ku4qo/SS-40-Digital-Transceiver/docs/ss-40-interconnect.pdf

## LCD 4x20

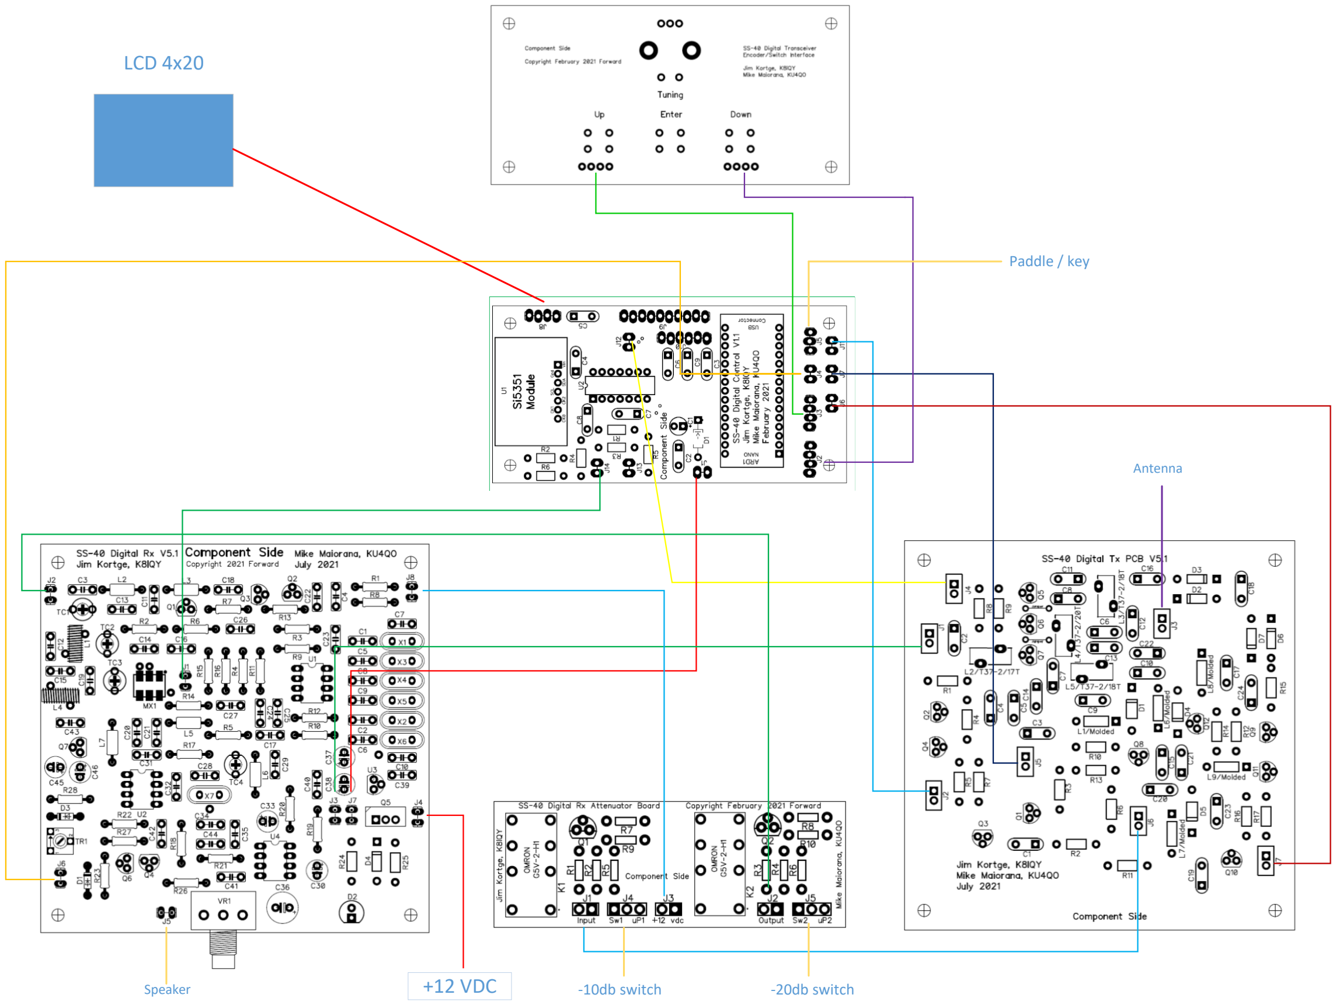
[picture p3: page 1]

## +12 VDC

Antenna

Speaker | -10db switch | -20db switch

Paddle / key
