ku4qo/SS-40-Digital-Transceiver/images/SS-40 Digital Transceiver - Controller-PowerSupplyMonitor-640 pix.jpg

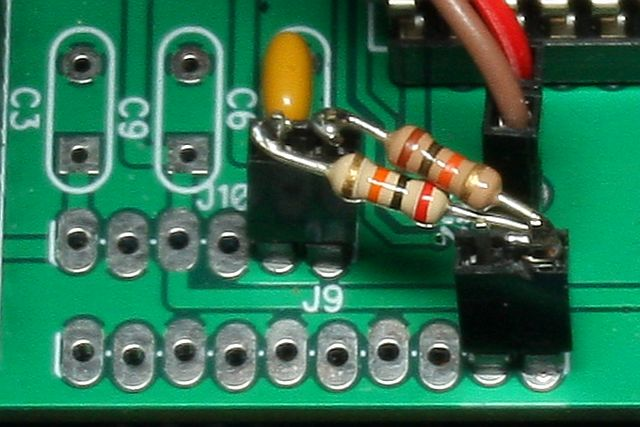
images/SS-40 Digital Transceiver - Controller-PowerSupplyMonitor-640 pix.jpg
