ku4qo/SS-40-Digital-Transceiver/images/SS-40 Digital Transceiver - Front2-1024 pix.jpg

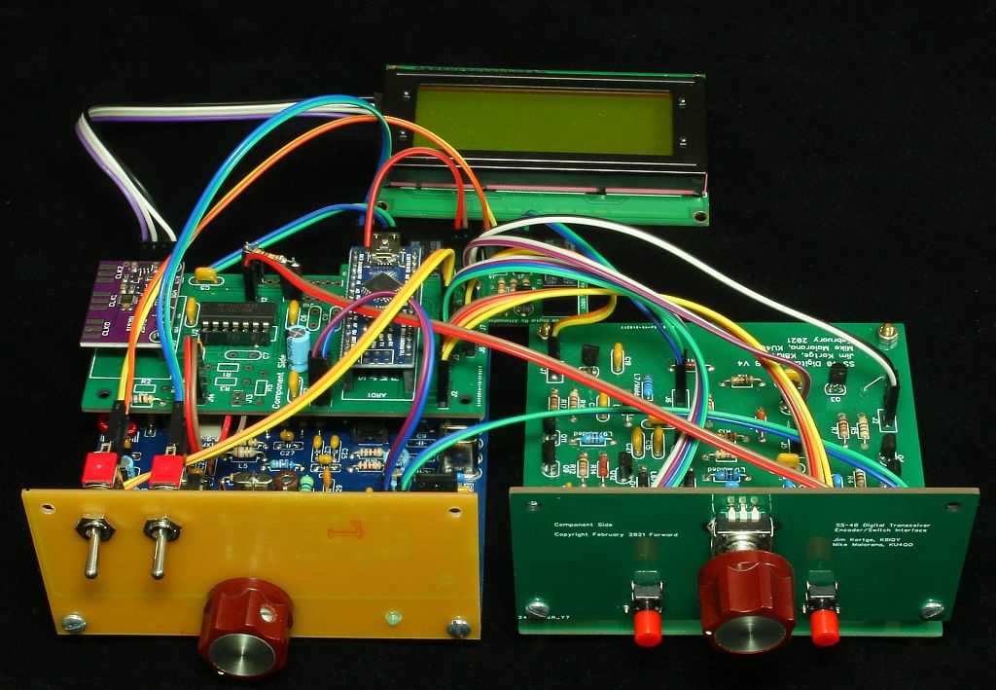
images/SS-40 Digital Transceiver - Front2-1024 pix.jpg
