ku4qo/SS-40-Digital-Transceiver/schematic/DipTrace Schematic - FrontEndAttenuatorV1.1.pdf

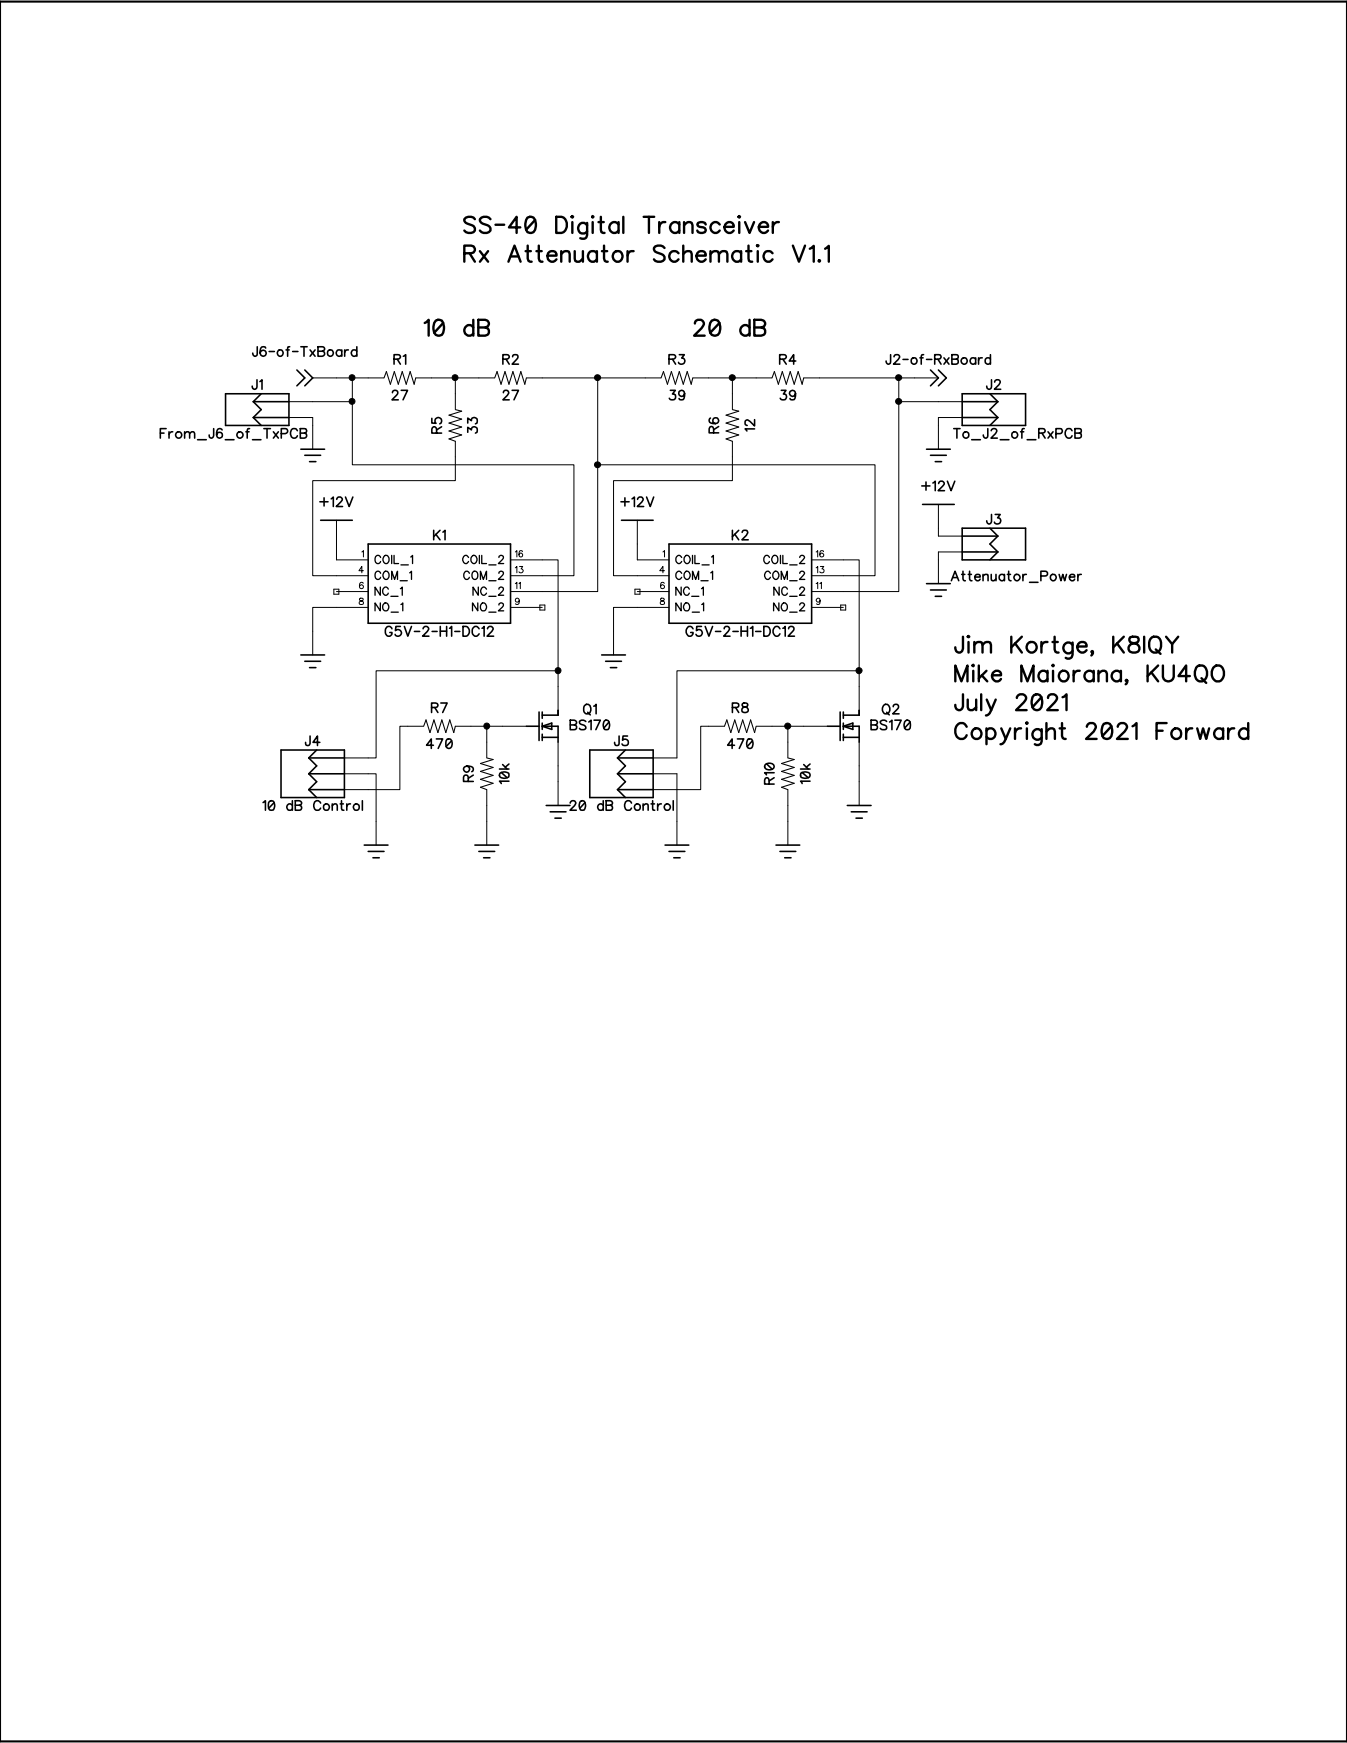
[picture p13: page 1]
