ku4qo/SS-40-Digital-Transceiver/schematic/DipTrace Schematic - SS-40Digital-Tx V5.1.pdf

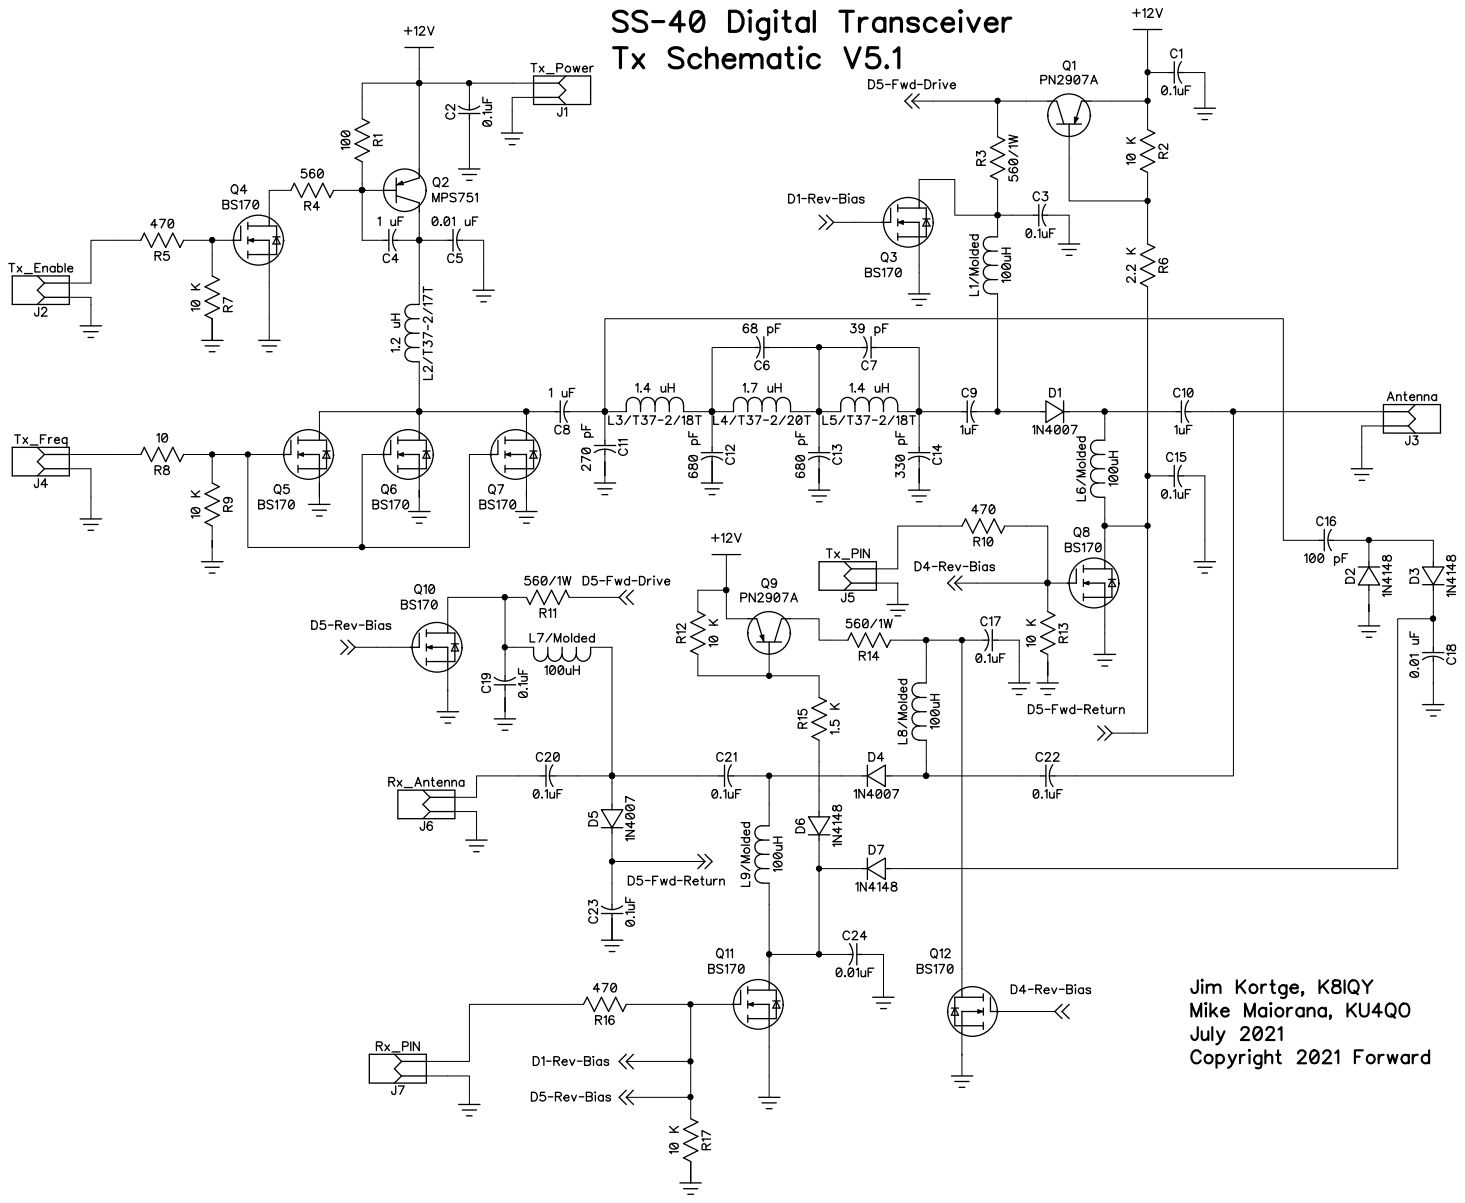
[picture p14: page 1]
