ku4qo/SS-40-Digital-Transceiver/schematic/DipTrace Schematic - SS-40DigitalControlV1.1.pdf

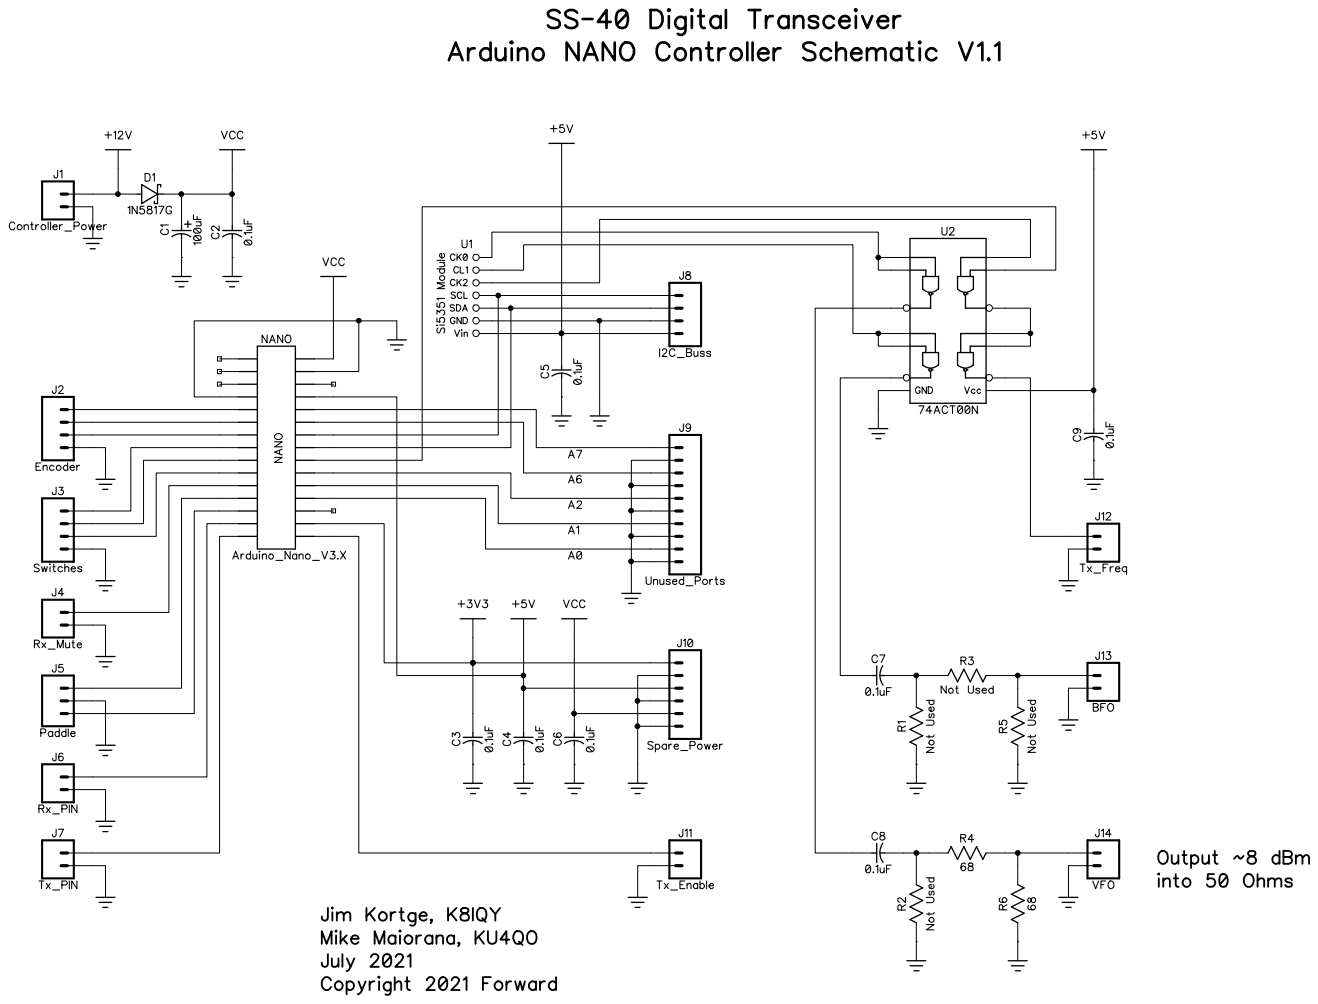
[picture p15: page 1]
