ku4qo/SS-40-Digital-Transceiver/schematic/DipTrace Schematic - SS-40RxDigitalV5.1.pdf

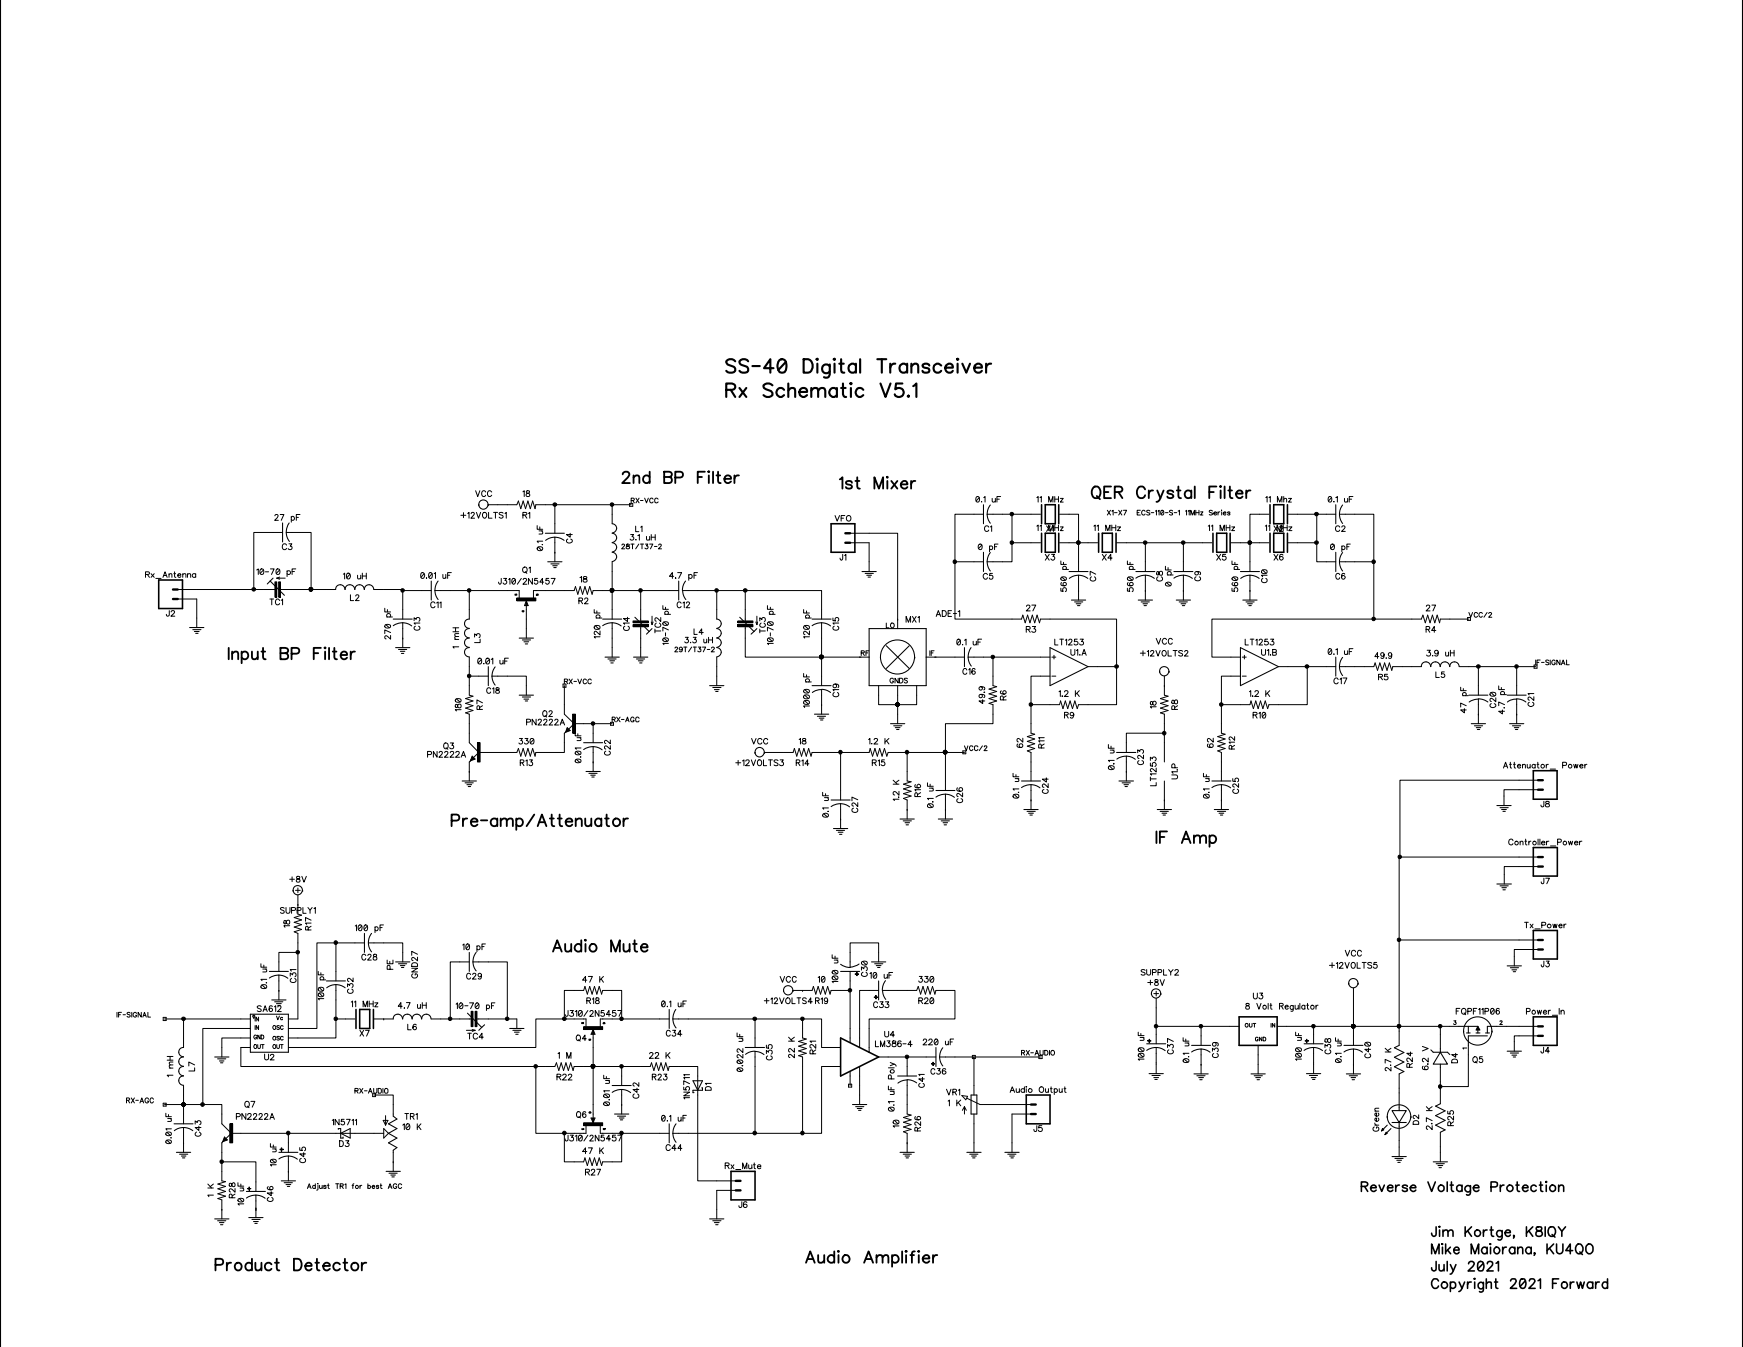
[picture p16: page 1]
