ku4qo/SS-40-Digital-Transceiver/pcb/DipTrace PCB - AttenuatorSwitchMountingV2.pdf

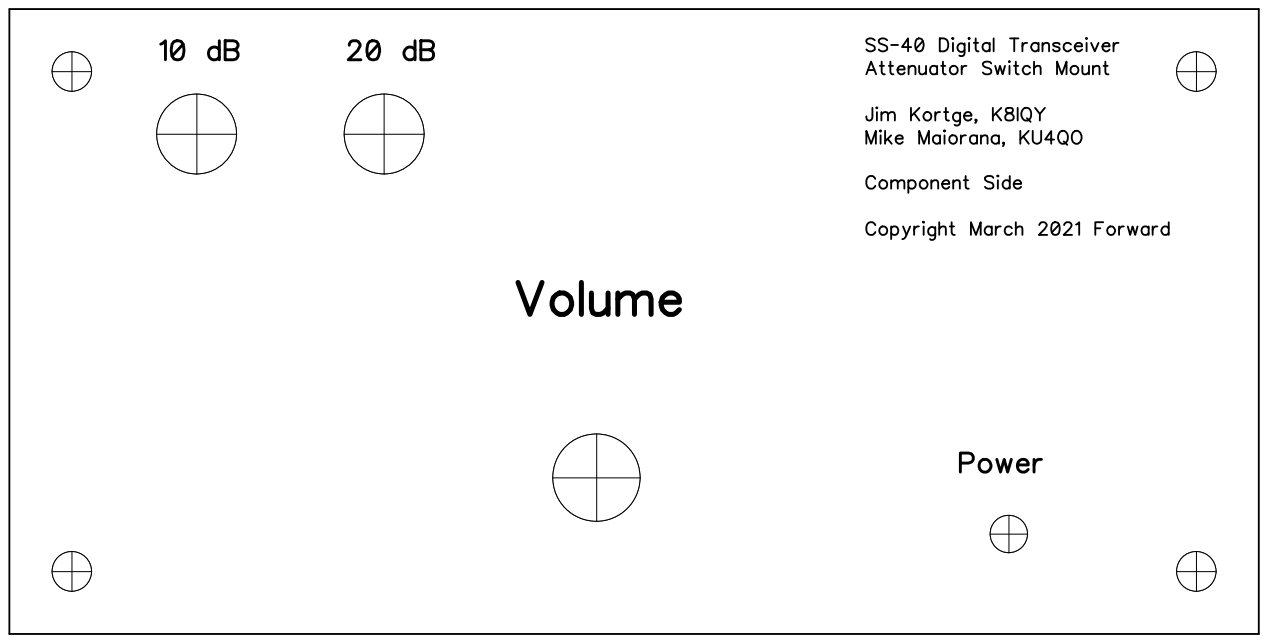
[picture p17: page 1]
