ku4qo/SS-40-Digital-Transceiver/pcb/DipTrace PCB - Encoder-Switch-MountingV2.pdf

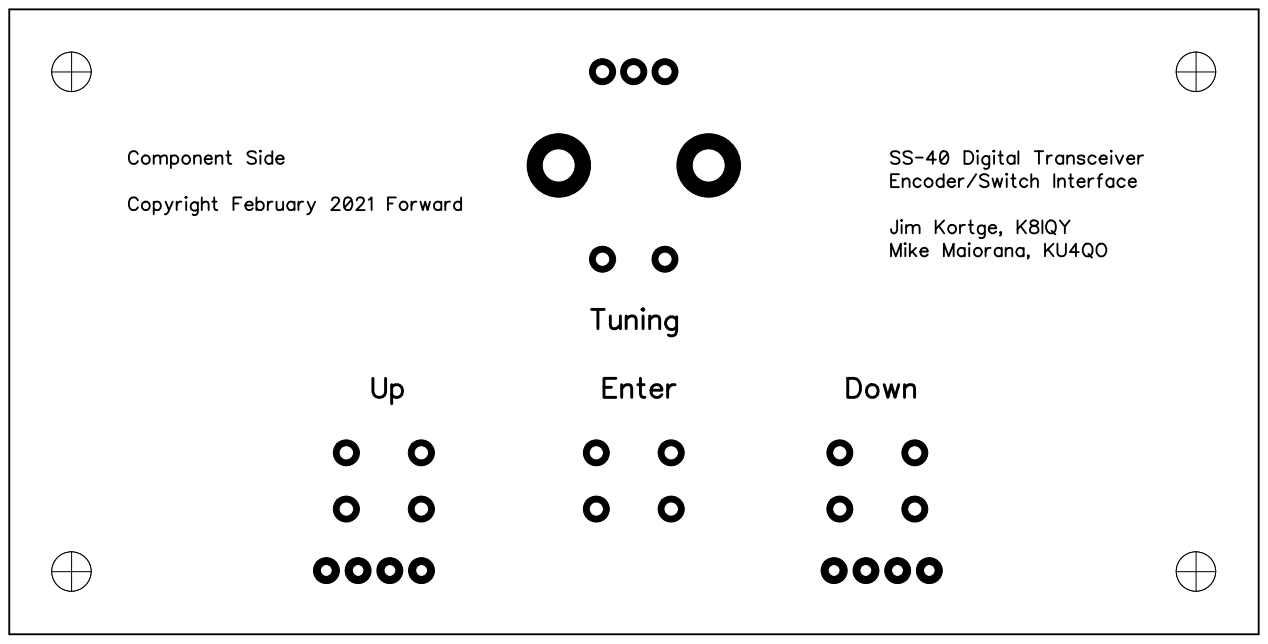
[picture p18: page 1]
