ku4qo/SS-40-Digital-Transceiver/pcb/DipTrace PCB - FrontEndAttenuatorV1.1.pdf

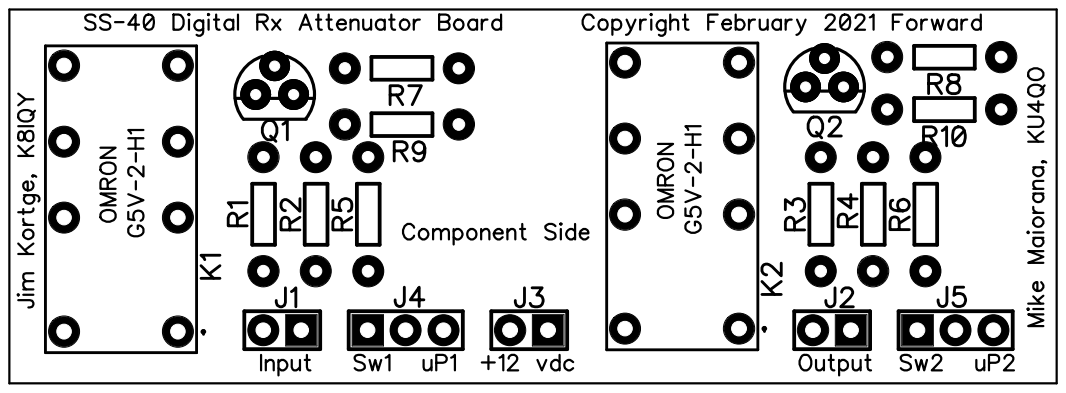
[picture p19: page 1]
