ku4qo/SS-40-Digital-Transceiver/pcb/DipTrace PCB - SS-40DigitalControlV1.1.pdf

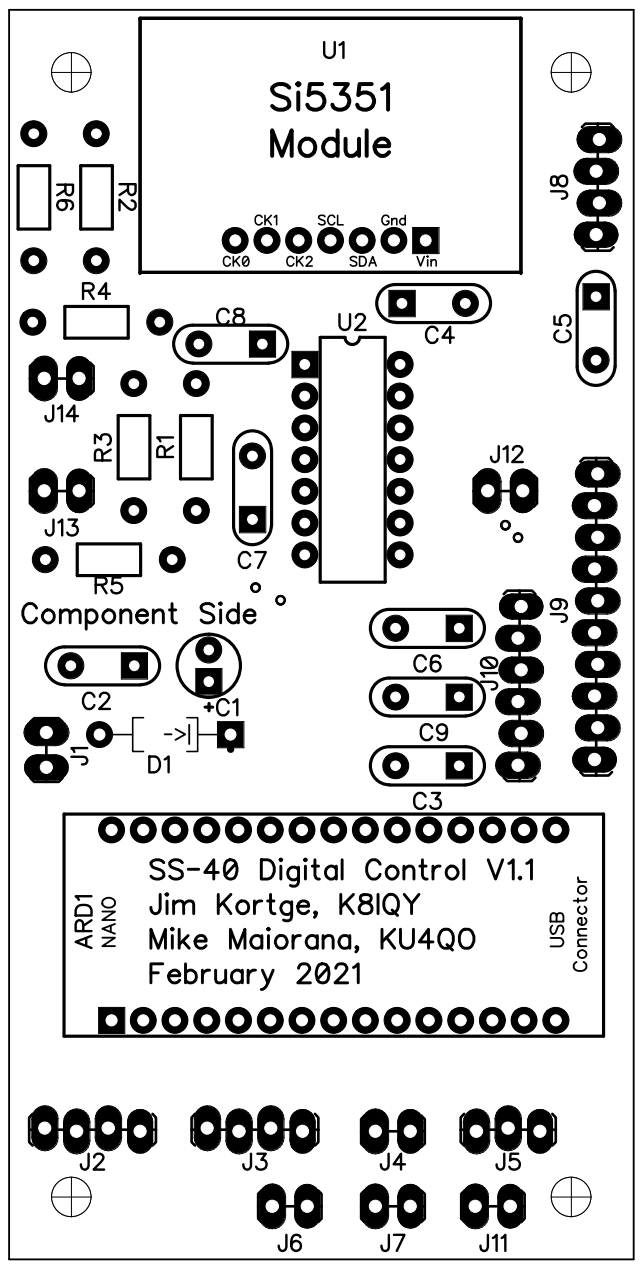
[picture p20: page 1]
