ku4qo/SS-40-Digital-Transceiver/pcb/DipTrace PCB - SS-40DigitalTxV5.1.pdf

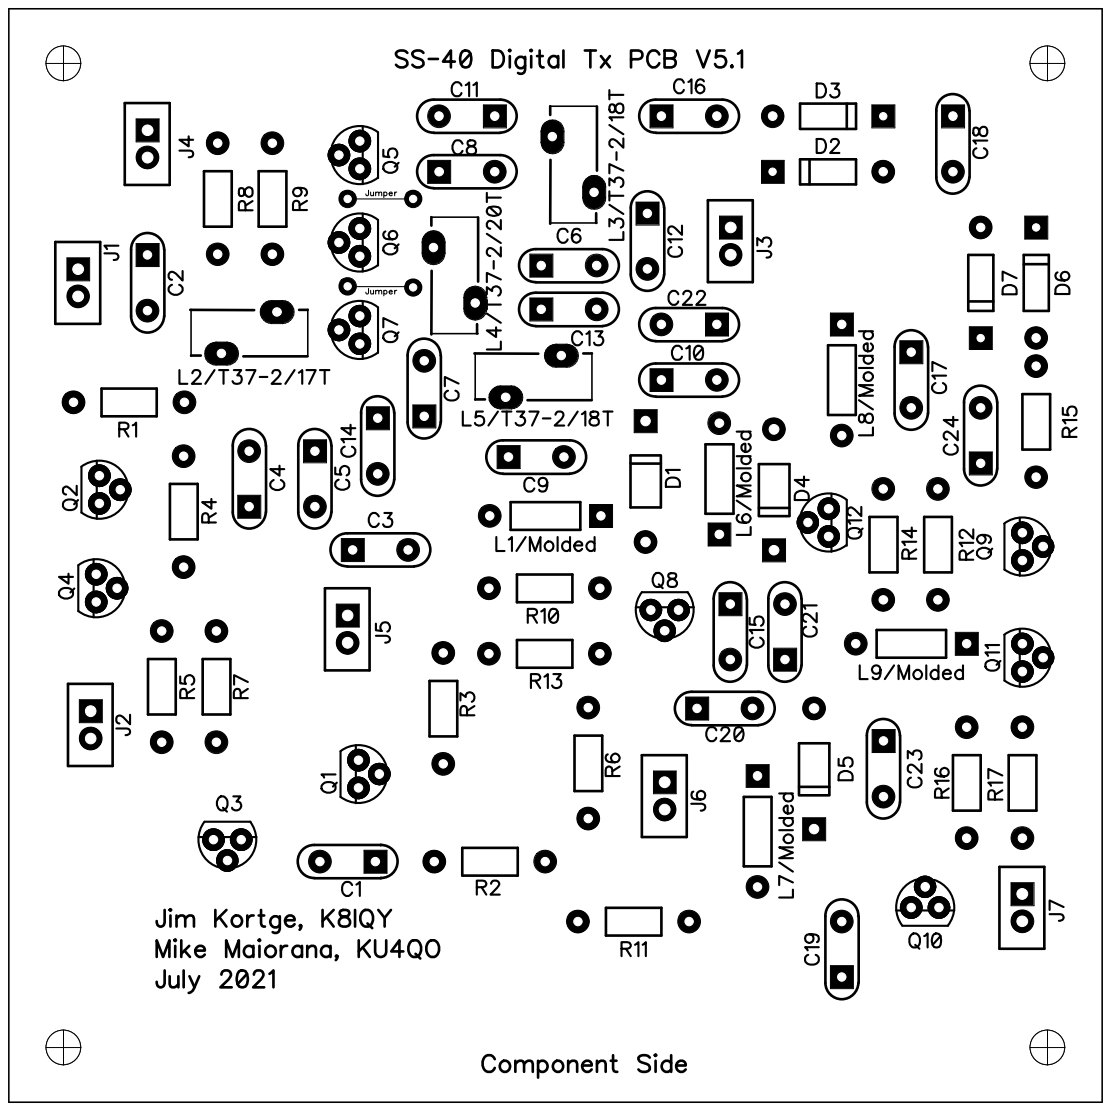
[picture p21: page 1]
