ku4qo/SS-40-Digital-Transceiver/pcb/DipTrace PCB - SS-40RxDigitalV5.1.pdf

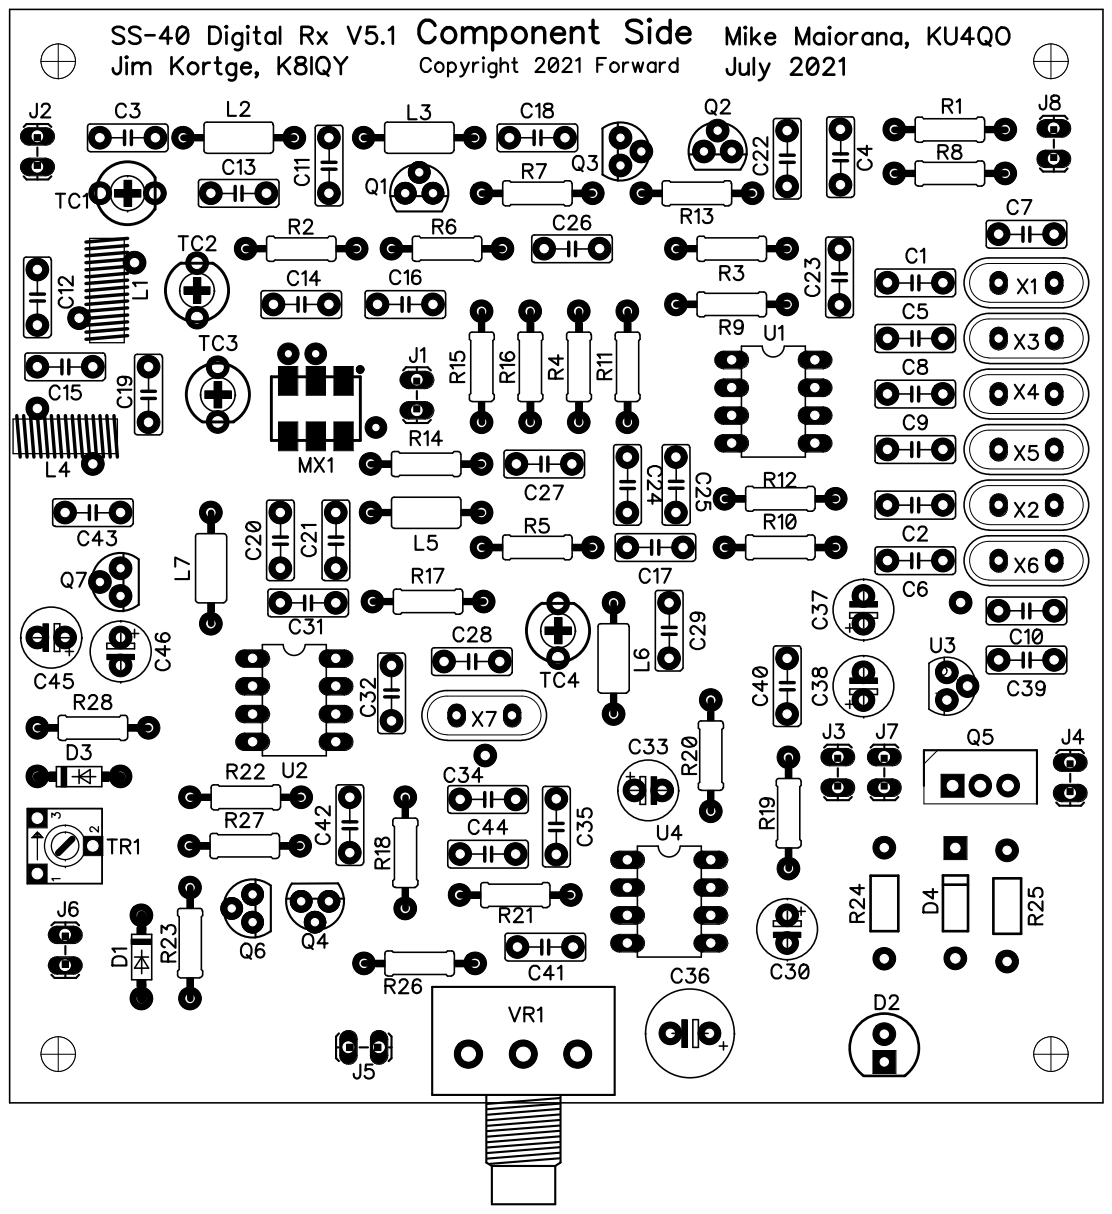
[picture p22: page 1]
