ku4qo/SS-40-Digital-Transceiver/(commit log)

2021-03-05 Add files via upload
    Fixed xmit sequence bug. Increased tune timeout to 10 seconds.
    [e_control.ino, ss-40-V4.ino]
2021-03-06 Menu readability - calibrate bug fix
    [d_keyer.ino, e_control.ino, g_calibrate.ino]
2021-03-06 Changed IF freq calibration to use clk2 as source
    also cleaned up and added calc_vfo() function
2021-03-18 Fix for sidetone correction with RIT active
    [e_control.ino]
2021-07-21 Add files via upload
    Changes for beta version PCBs
2021-07-28 Update SS-40 Digital Transceiver - Arduino NANO Controller V1.1 BoM.bom
    Added comment for the Si5351 module
2021-07-28 Update SS-40 Digital Transceiver - Arduino NANO Controller V1.1 BoM.bom
2021-07-31 Add files via upload
    Fixed name on board silkscreen
